maasijam/model_d_controller/README.md

# model_d_controller
Teensy LC based USB Midi-Controller for the Moog Model D App (and of course all other USB-MIDI devices)
<br />
> [!NOTE]
> The Teensy LC is no longer available. With a few modifications, you can also use a Teensy 4. But that's quite expensive. Here's a fork which supports now either an ESP32 H2 DevKitM, a Raspberry Pico or a Waveshare Zero RP2040: https://github.com/mgsg/20pi

<br />

Disclaimer: This is a DIY project. Use at your own risk.

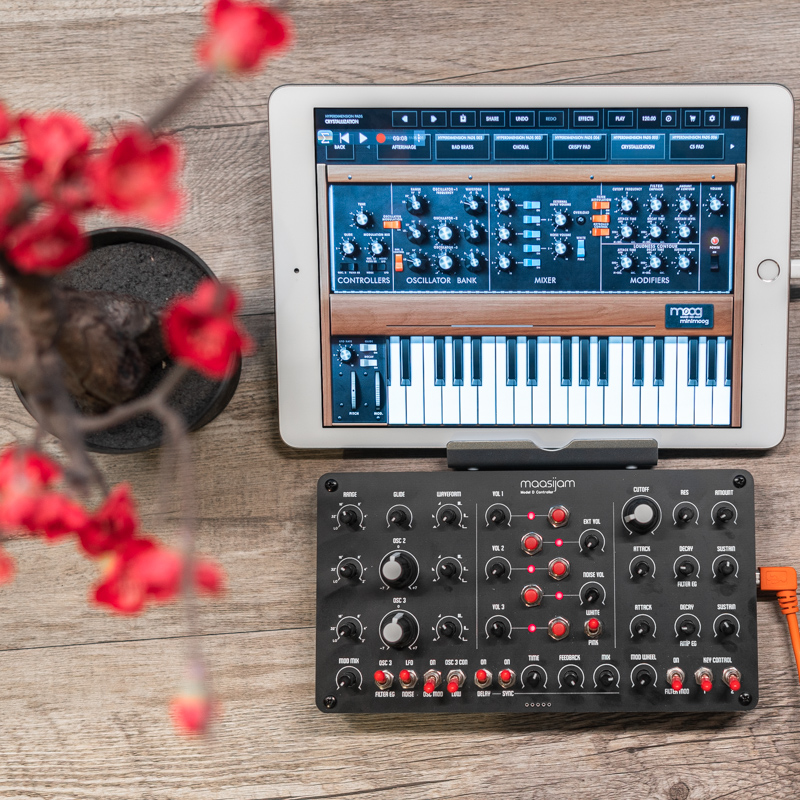
[picture p1: Images/maasijam_model_d_controller.jpg]
maasijam model d midi controller


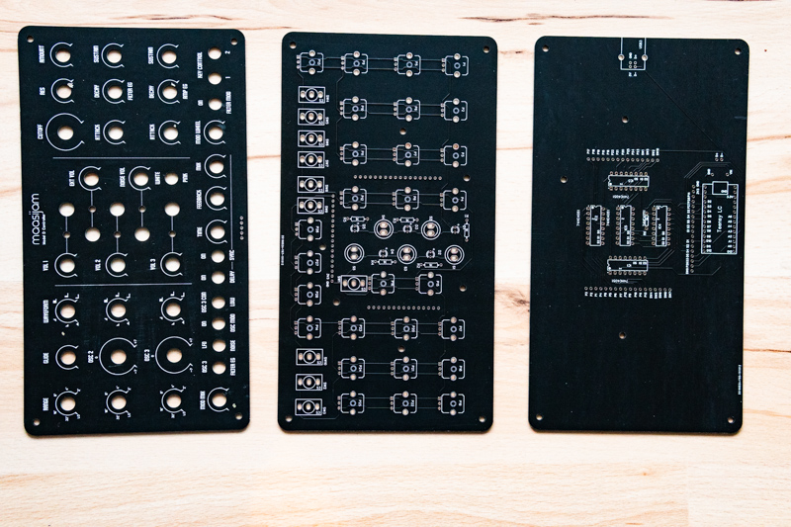
[picture p2: Images/maasijam_model_d_controller_pcbs.jpg]
maasijam model d midi controller PCBs


The controller in action (YouTube links)

Teensy DIY Midi Controller Jam - Moog Model D App, Fugue Machine (https://www.youtube.com/watch?v=qR_zFrnvdvk)

Teensy DIY Midi Controller Jam - Moog Animoog App, Fugue Machine (https://www.youtube.com/watch?v=HAJEskUzX2w)
