maasijam/model_d_controller/Hardware/model_d_controller_schematic.pdf

# S1 10 S0 11 Y3 12 Y0 13 Y1 14 Y2 15 VCC 16

# S1 10 S0 11 Y3 12 Y0 13 Y1 14 Y2 15 VCC 16

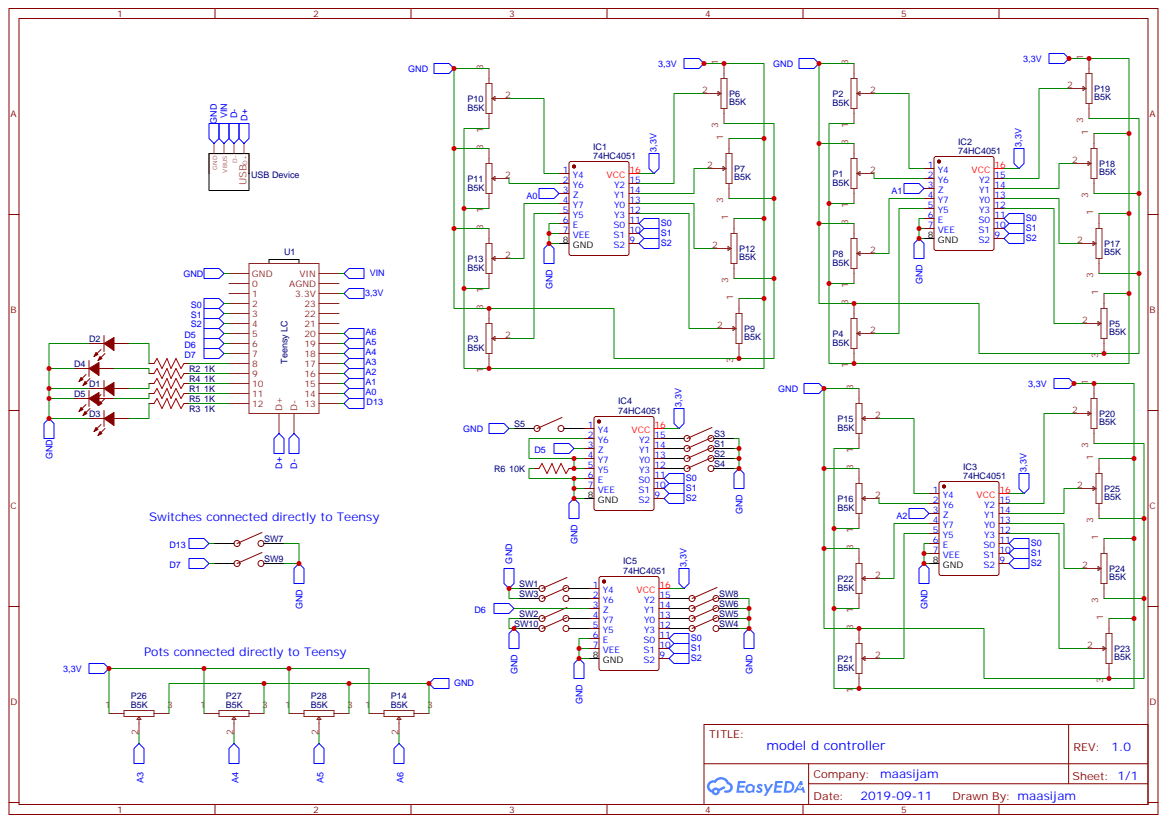
[picture p3: page 1]

Switches connected directly to Teensy

Pots connected directly to Teensy
