maasijam/model_d_controller/Hardware/modeld_controller_assembly_guide.pdf

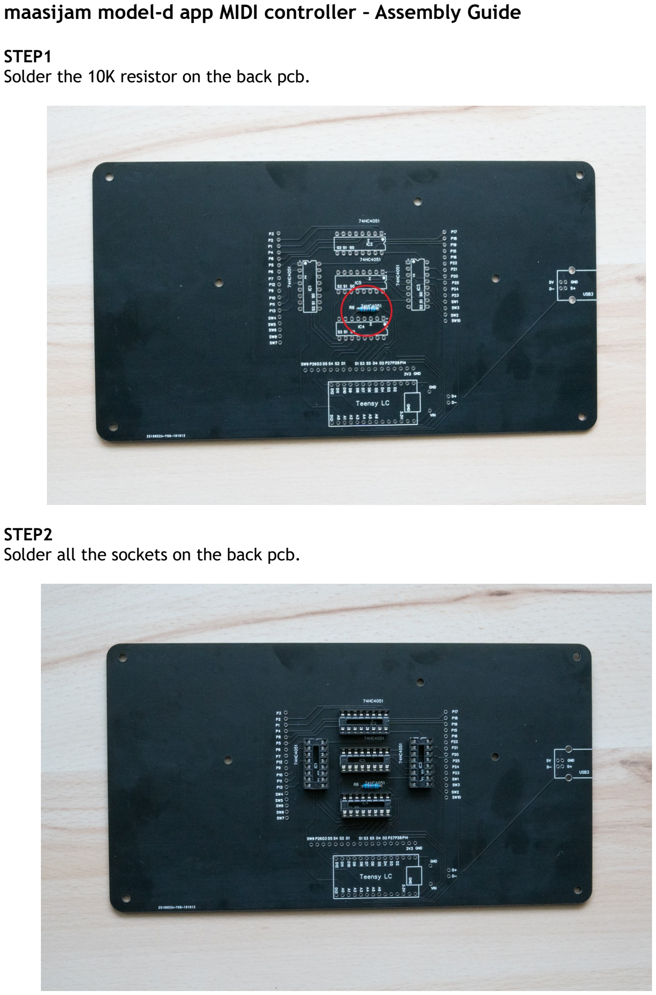
[picture p4: page 1]

maasijam model-d app MIDI controller – Assembly Guide

STEP1
Solder the 10K resistor on the back pcb.

STEP2
Solder all the sockets on the back pcb.

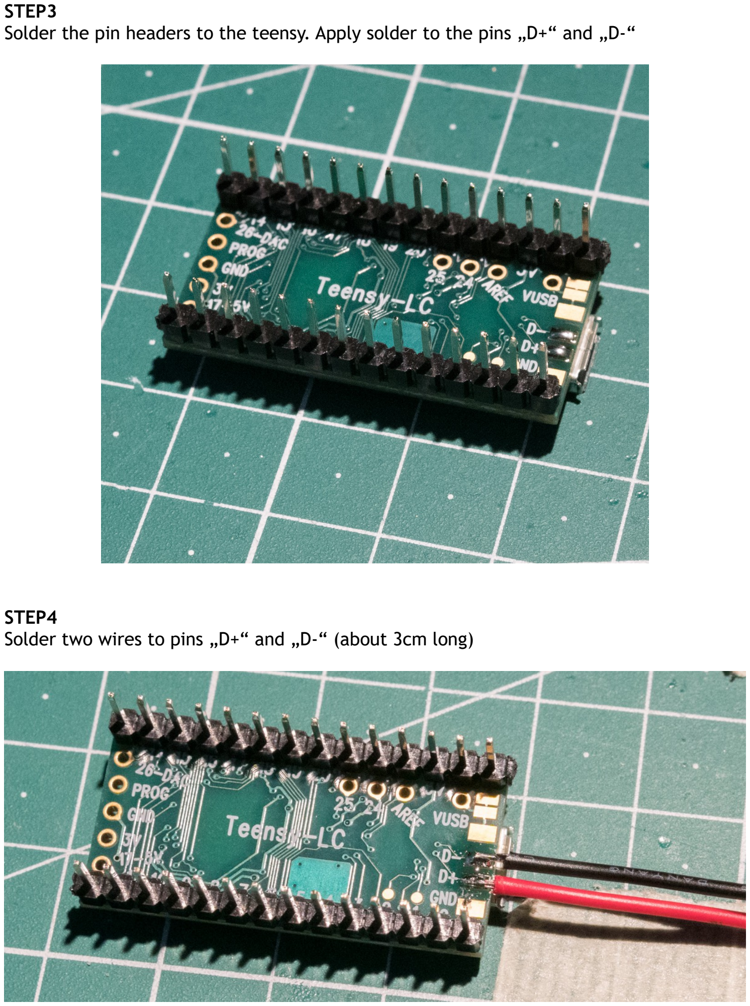
[picture p5: page 2]

STEP3
Solder the pin headers to the teensy. Apply solder to the pins „D+“ and „D-“

STEP4
Solder two wires to pins „D+“ and „D-“ (about 3cm long)

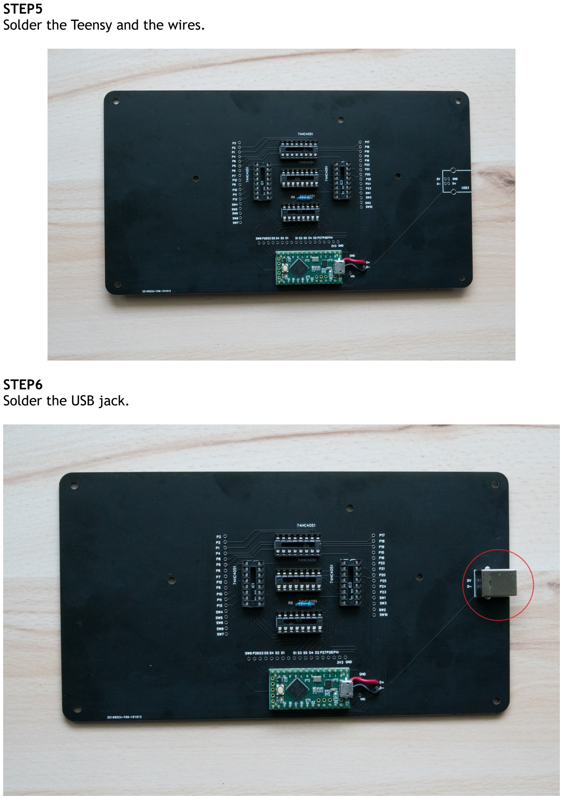
[picture p6: page 3]

STEP5
Solder the Teensy and the wires.

STEP6
Solder the USB jack.

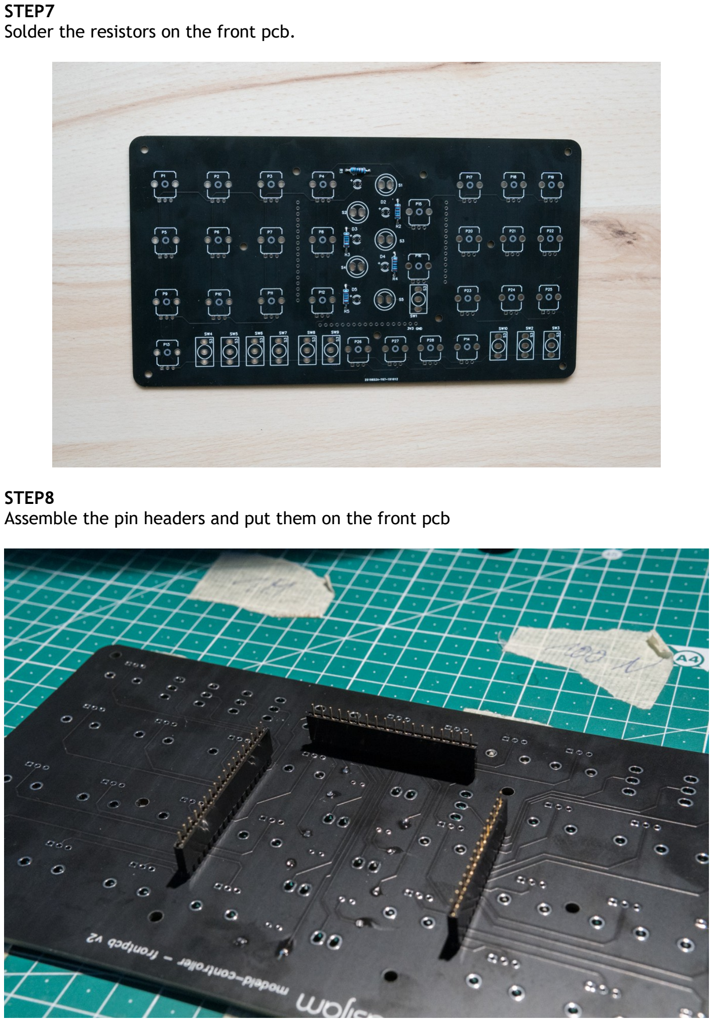
[picture p7: page 4]

STEP7
Solder the resistors on the front pcb.

STEP8
Assemble the pin headers and put them on the front pcb

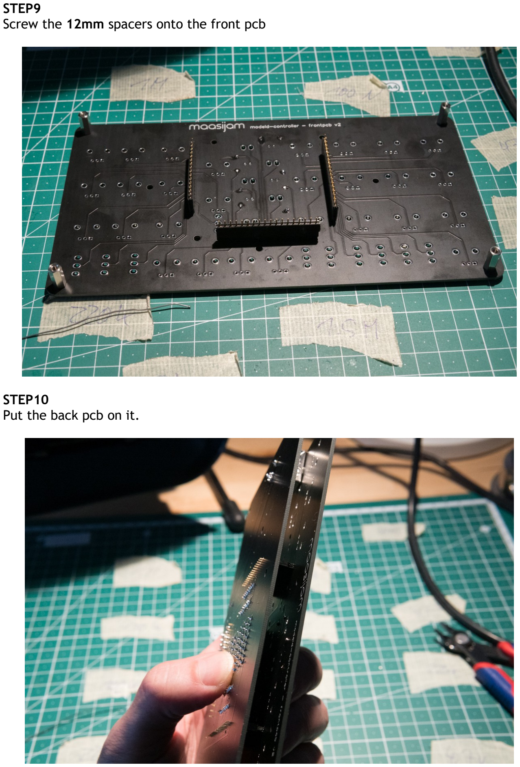
[picture p8: page 5]

STEP9
Screw the 12mm spacers onto the front pcb

STEP10
Put the back pcb on it.

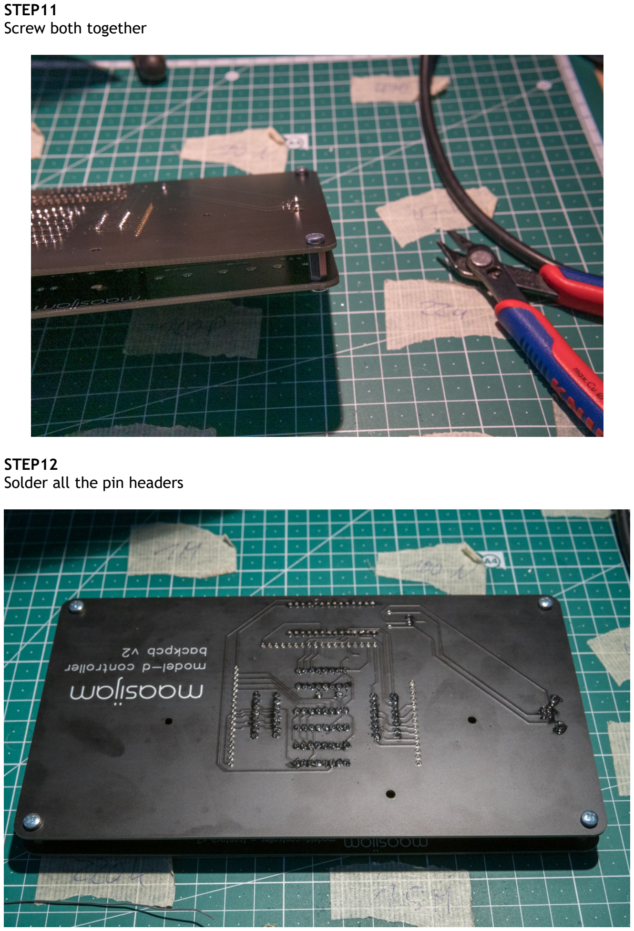
[picture p9: page 6]

STEP11
Screw both together

STEP12
Solder all the pin headers

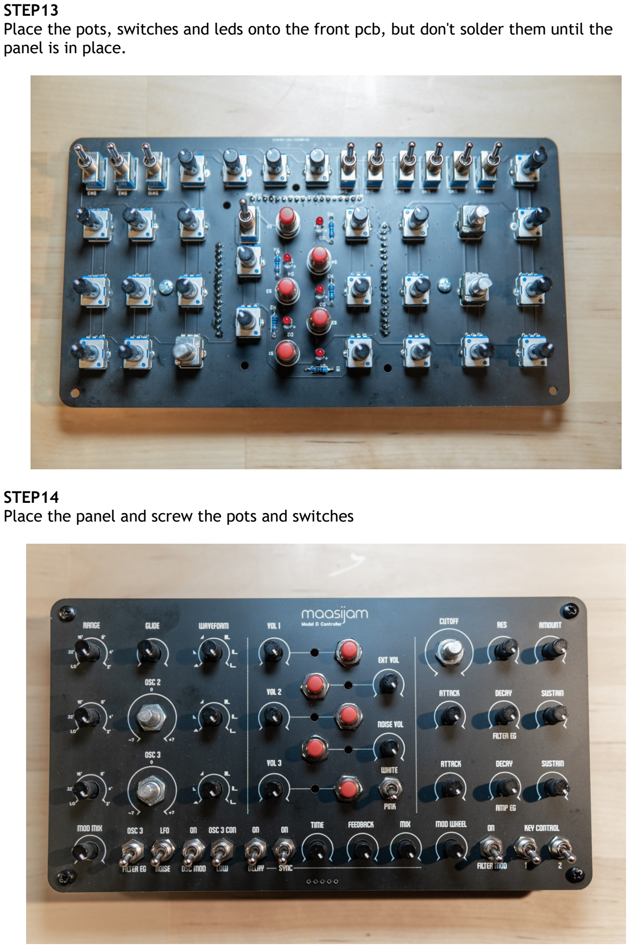
[picture p10: page 7]

STEP13
Place the pots, switches and leds onto the front pcb, but don't solder them until the panel is in place.

STEP14
Place the panel and screw the pots and switches

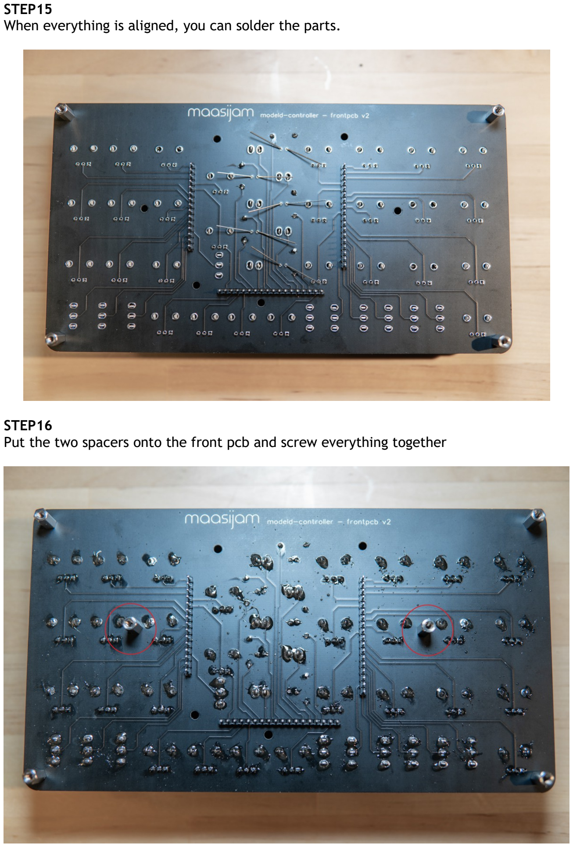
[picture p11: page 8]

STEP15
When everything is aligned, you can solder the parts.

STEP16
Put the two spacers onto the front pcb and screw everything together

Congratulations, you did it

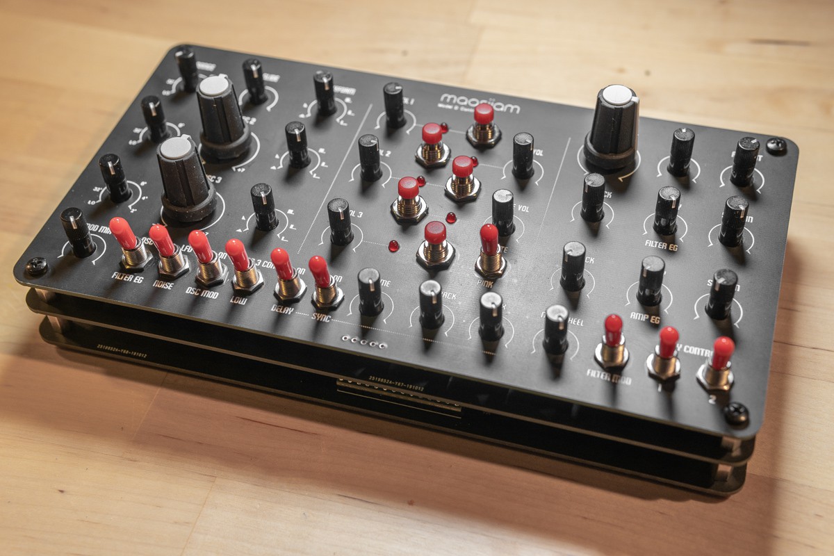
[picture p12: figure]
