maasijam/model_d_controller/(threads)

Thread 1 (2020-04-15):

Component List and PCBs

rafael-azevedo, 2020-04-15:
Hey quick question on this build. Do you have a component list available ? Also do you have any PCBs from your last run your willing to sell ?

maasijam, 2020-04-15:
Hi, there is a "Hardware" folder with all the files you need!

maasijam, 2020-05-17:
Sorry, I am currently not selling PCBs. Please use the Gerber files in the hardware folder to order the PCBs

Closed 2020-05-17.

Thread 2 (2020-05-13):

Availablilty of parts and additional D+/- GND/VIN

RoelStierum, 2020-05-13:
Dear Maasijam,

Many thanks for posting the code and materials listing to build a controller for the Moog Model D app. Your generosity is really appreciated. Together with my dad, who is actually the one who is planning to use the controller, we plan to make this a joint summer holiday project, in case we are still homebound because of COVID-19. We have a few questions and hope you are willing and can help us:
1)	Some of the materials appear to be out of order from the websites you have indicated. As the specs are not always clearly indicated on these websites, do you know of any alternative suppliers than can provide the following parts? I've found some alternatives but i do not know if they are compatible, could you also be so kind to take a look at those parts?

_Unavailable parts_
B5K D Shaft Alpha 9mm | 3 | https://www.thonk.co.uk/shop/alpha-9mm-pots-dshaft/
Toggleswitch SPDT | 10 | https://www.musikding.de/Toggleswitch-SPDT
Red Push Button Befaco | 5 | https://www.thonk.co.uk/shop/befaco-parts/

_Alternative parts_
Toggleswitch - https://www.aliexpress.com/item/33033085981.html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,searchweb201602_,searchweb201603_

Red push button befaco - https://www.aliexpress.com/item/32711341102.html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,searchweb201602_,searchweb201603_

2)	On the Gerber PCB files there seems to be an additional D+/D- GND/VIN, so not were the USB socket will be: is this for an additional power supply, e.g. to not drain power from the iPad? These connections are located next to the teensy board.
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

3)	I assume the controller can be combined with a piano type key bed using a midi hub?

4)	Once we get going, and stumble upon questions, would you be willing to share further experiences if needed?

Many thanks, stay healthy! By the way we enjoyed very much the nice minimoog synth sounds from your youtube channel!

Best regards,

Roel and Rob

maasijam, 2020-05-17:
Hi,
glad you like my controller.
I just uploaded an assembly guide. I hope that makes everything a little more understandable.

The alternative parts for the switches and buttons look correct.
As an alternative to the d-Shaft Alpha you could take them here:
https://www.musikding.de/Poti-9mm-5k-lin-Print-vertikal
But they are not d-shaft, so you need other knobs.
You could also take 10K pots. It's only important that they are linear.

Yes, you can combine the controller with other midi devices via usb hub.

Feel free to ask if you have problems. When I have the time I will try to answer.
Best regards
tom

robmoog, 2020-07-27:
Dear Maasijam,

We have assembled the model D controller and it all works great!! Many many thanks for helping to bring the Minimoog app much more alive, I will use the controller frequently in my band!

One suggestion from our site for  the assembly guide may be to add in step 4 and step 5 also some text describing the two additional wire connections  needed soldering (GND, VN), b. And for the components list on the led perhaps to mention that 75 mcd is sufficient, but perhaps to the more experienced developer all of this is obvious, then never mind.

Finally the controller has some additional knobs that I couldn't midi map straight away within the Minimoog app (on/delay, on/sync, time, feedback and mix). Are these for communication to an additional app running in the background (e.g. for looping?) , e.g. via AUM?

Cheers Rob

maasijam, 2020-07-30:
Hi Rob,

great to hear that you successfully assembled the controller.
Thanks for the suggestions for the assemby guide, but you don't have to solder additional wires to the GND/VIN pins. These pins are completly useless, and I will remove them in the next version. But maybe I didn't understand you correctly.

The additional knobs (on/delay, on/sync, time, feedback and mix) are for controlling the delay effect of the model-d app. If you use the moog model-d app you can find  the delay under the "EFFECTS" tab.

Best regards
Tom

robmoog, 2021-08-01:
Dear Tom

Just wanted to share a picture of a casing I made of your controller! Still brings so much fun to my music making. Cheers Rob

Verstuurd vanaf mijn iPhone

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

maasijam, 2021-08-02:
Hi Rob,

I can't see your picture! Maybe because the issue is closed?

Best regards
Tom

> Dear Tom Just wanted to share a picture of a casing I made of your controller! Still brings so much fun to my music making. Cheers Rob

robmoog, 2021-08-03:
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

robmoog, 2021-08-03:
Dear Tom, I added it from the github environment, hope you can see it, cheers Rob

Verstuurd vanaf mijn iPhone

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

maasijam, 2021-08-03:
Wow, that looks awesome. Thanks for sharing this picture.
Best regards
Tom

gallivas, 2023-08-19:
I'm so excited to try my hand at building one of these. Thank you Maasijam for putting all this documentation together. I recently subscribed to your YouTube channel after seeing one of your Model D jams.

I was wondering if you would recommend the [Teensy 4.0](https://www.pjrc.com/store/teensy40.html) at this point as opposed to the LC considering the LC is no longer made. I'm new to building this sort of thing, so I'm curious if using the 4.0 instead will cause any issues.

Also, I compiled a list of US suppliers for components that you may wish to reference for any of your US-based subscribers looking to build this. I've attached it below. If you have a moment, I'd be curious to know if any of the components I linked are incorrect for this build. I tried to find the most similar products I could.

[BOM_maasijam_modeld_controller.csv](https://github.com/maasijam/model_d_controller/files/12386332/BOM_maasijam_modeld_controller.csv)

maasijam, 2023-08-20:
Hi,
with a little hack the Teensy 4 should work. You have to use the onboard micro usb connector for the d+/d- pins.

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

And thanks for the modified BOM - I will exchange it.

Best regards
Tom

Closed 2020-05-17.

Thread 4 (2025-01-28):

Teensy LC depracated. Any updates for newer board in the works

Hastyman, 2025-01-28:
Hello,

A friend of mine forwarded me this project recently and it looks like a great build. When I went to spec it out I noted the LC is no longer available due to a chip shortage. Have you considered updating the board for use with the 4.0 or 4.1?

maasijam, 2025-01-29:
Hi,
please look here: https://github.com/maasijam/model_d_controller/issues/2#issuecomment-1685246679

Hastyman, 2025-01-30:
Thanks for that link. When searching this repository I couldn't find a discussion section to review. Oddly enough I never noticed both boards share the same footprint. Wonder if you could use the D+ and D- pads on the underside of the Teensy 4.0 instead of hacking a micro USB connector?

maasijam, 2025-01-31:
The pins on the back side are usb host ones. So you would have to change the firmware.

Hastyman, 2025-01-31:
That makes sense. I didn't even consider that when looking at the pinout.
