maasijam/model_d_controller/(commit log)

2019-12-01 Add gerber files
2019-12-01 upload schematic
2019-12-01 upload pcb image
2019-12-01 move arduino files to software folder
2019-12-01 move arduino files
2019-12-02 upload bom
    [BOM_maasijam_modeld_controller.csv]
2020-05-17 Upload assembly guide
